tltangliang/open-PoE-Pi-HAT/hardware/BOM_open PoE+ Pi HAT_open PoE+ Pi HAT_2024-05-05.xlsx

No. | Quantity | Comment | Designator | Footprint | Value | link
1 | 3 | 100nF | C14,C18,C24 | C0603 | 100nF
2 | 3 | 22uF | C15,C16,C17 | C0603 | 22uF
3 | 1 | 1uF | C21 | C0603 | 1uF
4 | 1 | 47uF | C22 | CAP-SMD_BD6.3-L6.6-W6.6-LS7.2-FD | 47uF
5 | 1 | 4.7uF | C23 | C1206 | 4.7uF
6 | 2 | PM254-2-02-S-8.5 | CN1,CN2 | HDR-SMD_4P-P2.54-V-F-R2-C2-S7.2
7 | 1 | FH-00339 | H1 | HDR-SMD_40P-P2.54-V-F-R2-C20-S6.6-EH
8 | 1 | 1.2uH | L3 | IND-SMD_L5.4-W5.2 | 1.2uH
9 | 1 | 330kΩ | R14 | R0603 | 330kΩ
10 | 1 | 27kΩ | R15 | R0603 | 27kΩ
11 | 1 | 220kΩ | R16 | R0603 | 220kΩ
12 | 1 | 28.7kΩ | R17 | R0603 | 28.7kΩ
13 | 1 | 10kΩ | R18 | R0603 | 10kΩ
14 | 1 | 1.5kΩ | R19 | R0603 | 1.5kΩ
15 | 1 | TPS51396ARJER | U3 | QFN-20_L3.0-W3.0-P0.45-BL-EP1.0 |  | https://www.ti.com/product/TPS51396A
16 | 1 | 12V/2A | U5 | WisdPi_PoE+_Module_DIP | 12V/2A
