tltangliang/open-PoE-Pi-HAT/hardware/SCH_open PoE+ Pi HAT_2024-05-05.pdf

## +5VSGND

# 12V to 5v 8A

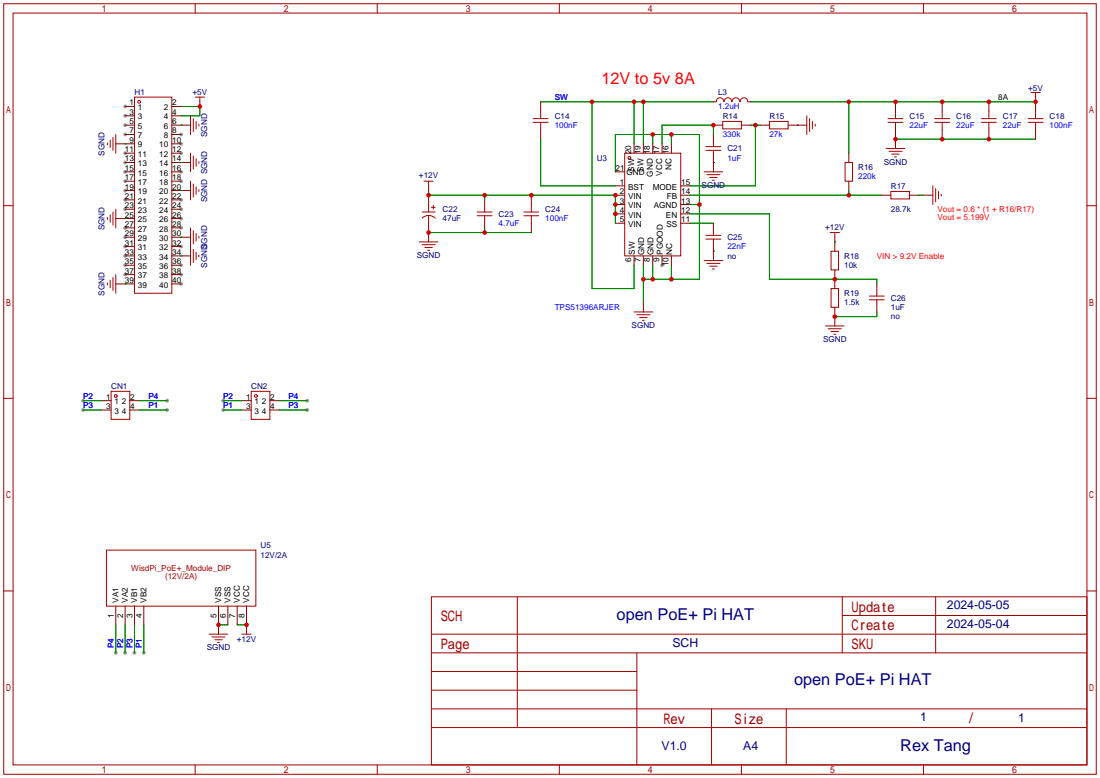
[picture p5: page 1]

SGND SGND

2024-05-04 open PoE+ Pi HAT
