tltangliang/open-PoE-Pi-HAT/(list of files, drawings)

Other design files:
hardware/EasyEDA_Project_open PoE+ Pi HAT_2024-05-05.epro
