tltangliang/open-PoE-Pi-HAT/(commit log)

2024-05-05 Add BOM
    [BOM_open PoE+ Pi HAT_open PoE+ Pi HAT_2024-05-05.xlsx]
2024-05-05 Add SCH/PCB pic
